nakomis/iphone-remote/hardware/fob/README.md

# Fob board

The trigger fob's PCB, generated by code from the circuit outward. The pipeline is adapted from
tinycrypt's `hardware/key-board` (circuit as Python, EasyEDA footprints via easyeda2kicad,
Freerouting, KiCad DRC, then JLCPCB fab files). The design is in
[`docs/superpowers/specs/2026-11-05-iphone-remote-fob-design.md`](../../docs/superpowers/specs/2026-11-05-iphone-remote-fob-design.md).

**Stage:** laid out and DRC-clean (IREM-4). Next: JLC quote (IREM-5).

## Build

```bash
ASDF_PYTHON_VERSION=3.11.15 python -m venv .venv
.venv/bin/pip install -r requirements.txt
./fetch_parts.sh             # only if footprints/ is missing or a part is added (resumable)
mkdir -p freerouting && cp <somewhere>/freerouting-2.5.0.jar freerouting/   # Java via asdf
.venv/bin/python build.py --route   # full route log: /tmp/irem-fob-route.log
.venv/bin/python -m pytest
```

There's no drawn schematic: `board/fob_board.py` *is* the schematic, and `out/fob/netlist.txt`
lists every net. Comments in it carry Nordic's reference designators (C1 to C10, L1 to L3, X1)
so it can be checked line by line against Nordic's "QCAA QFN32 with DC/DC regulator setup".

## Circuit

| Ref | Part | Notes |
|---|---|---|
| U1 | nRF52810-QCAA-R (C519278) | QFN-32, 0.5 mm pitch |
| BT1 | MY-2032-12 CR2032 holder (C964833) | side clips +, centre pad − |
| C11 | 22 µF 0805 | bulk, at the holder |
| C9, C5, C8 | 4.7 µF, 100 nF, 100 nF | VDD pins 32, 9, 25 |
| C4, C7 | 100 nF, 100 pF | DEC1, DEC3; DEC2 not connected (Nordic C6 N.C.) |
| L2, L3, C10 | 10 µH, 15 nH, 1 µF | DC/DC: DCC → L2 → L3 → DEC4 |
| Y1, C1, C2 | 32 MHz CL 8 pF (C718072), 12 pF ×2 | |
| C3, L1 | 0.8 pF shunt, 3.9 nH series | Nordic's match → 50 Ω `RF` |
| CA1, R3, CA2 | DNP, 0 Ω, DNP | π footprint for retuning the antenna by hand |
| AE1 | Johanson 2450AT18D0100E (C2917718) | pad 1 feed, 2–4 GND (fed from the left) |
| SW1, R2 | TS-1187A (C318884), 1 MΩ pull-up | P0.06, active low |
| D1, R1 | red 0603 LED (C2286), 470 Ω | P0.09, active high |
| JP1–JP3 | solder jumpers to GND | P0.12 / P0.14 / P0.15 = ID bits 0 / 1 / 2 |
| J1 | Tag-Connect TC2030 (legged) | 1 VBAT, 2 SWDIO, 3 nRESET (P0.21), 4 SWDCLK, 5 GND, 6 SWO (P0.18) |
| J2 | 2×6 1.27 mm header, **not fitted** | 1 VBAT, 2 GND, 3 P0.25, 4 P0.00, 5 P0.28, 6 P0.01, 7 P0.30, 8 P0.04, 9 P0.16, 10 P0.05, 11 P0.20, 12 P0.10 (ordered to suit the routing) |

22 parts are assembled, with 7 extended parts. Every LCSC part was checked as in stock and
"Economic and Standard" on its JLC page on 5 Nov 2026.

## Layout (IREM-4)

`build.py --route` writes `out/fob/`: the board (`iphone-remote-fob.kicad_pcb`), `drc.json`,
`bom.csv`, `cpl.csv`, the gerbers zip, top and bottom renders, and
`iphone-remote-fob-outline.dxf` (board edge + courtyards, for the case). Fab files are written
only when KiCad's DRC has no errors and nothing unconnected. Freerouting isn't deterministic;
rerun if a run leaves something open.

- **Board:** 29 × 47 mm, 2 layers, 1.6 mm, every part on top. Antenna on the top edge, the
  nRF52810 just below it with the TC2030 to its right, the unpopulated breakout under the chip,
  the ID jumpers (labelled 1 / 2 / 4) under the TC2030, button and LED below, the CR2032 at the
  far end.
- **Hand-routed** (`board/fob_layout.py`, `rf_hand_route`): the RF chain, crystal, DEC1/3/4, the
  DC/DC, VDD to its three caps, escapes to vias for the pins the router couldn't reach, and the
  TC2030 fan-out (one track per gap between its leg holes, to vias outside them). Freerouting
  does the rest.
- **B.Cu kept solid** under the chip and under the RF line (router keep-outs), with nine vias in
  the chip's exposed pad and GND stitching on a 1.5 mm grid elsewhere.
- **Every GND pad joins the pour solidly** (no thermal spokes).
- **Courtyard overlaps are warnings, not errors** (`kicad_pcb.py` rule severities): the 0402s
  round the QFN sit inside its generous courtyard by design.
- The remaining warnings are silk overlaps and one unused fan-out via.

## Layout rules (from the antenna datasheet)

- **Antenna** (Johanson datasheet, evaluation-board layout): edge-mounted, on the board edge,
  with **no copper on any layer** in a 4.0 × 6.0 mm area around it (pads plus 4.1 mm into the
  board). No battery or metal under it. Grounded-coplanar 50 Ω feed through the R3/CA1/CA2 π.
- Put the antenna at the end away from the button and the CR2032 holder.
- Everything on the top side (JLC Economic). The bottom is ground pour.

## Footprint notes

- `fetch_parts.sh` hit EasyEDA's rate limit for four basic two-pin passives (C1035, C27143,
  C25117, C26083). They use already-fetched footprints of the same package (C0603, L0402,
  R0402), with pin name = pad number, which is all a two-pin part needs.
- The EasyEDA symbols type every pin "unspecified", so `check()` can't catch an unconnected
  power pin; `tests/test_fob_board.py` checks every nRF52810 pad explicitly.
- `footprints/local.pretty` holds KiCad 10 stock footprints: the TC2030 legged footprint, the
  solder jumper and the 2×6 1.27 mm header.
