nakomis/iphone-remote/hardware/fob/art/kappa-photo.jpeg

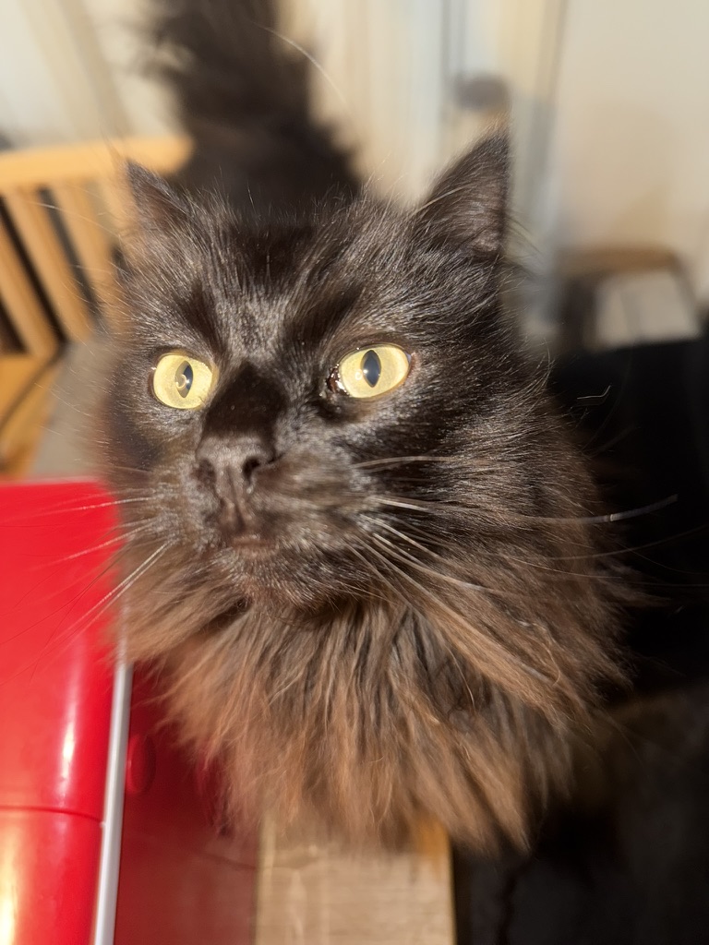
hardware/fob/art/kappa-photo.jpeg
