nakomis/iphone-remote/hardware/fob/art/kappa.png

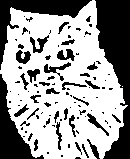
hardware/fob/art/kappa.png
