nakomis/iphone-remote/hardware/fob/out/fob/iphone-remote-fob-bottom.png

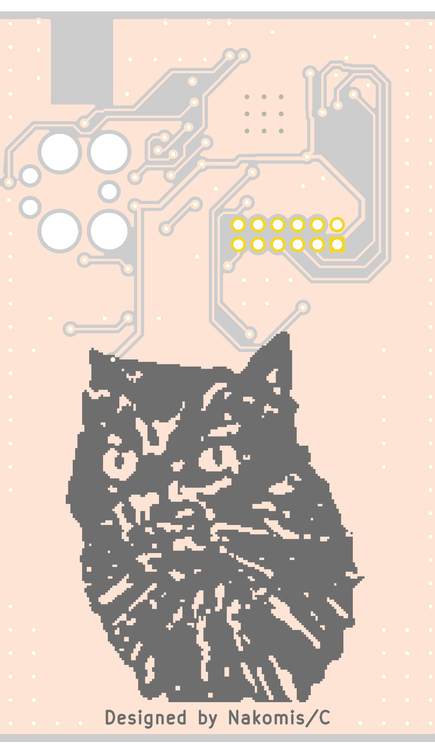
hardware/fob/out/fob/iphone-remote-fob-bottom.png
