nakomis/iphone-remote/hardware/fob/out/fob/iphone-remote-fob-top.png

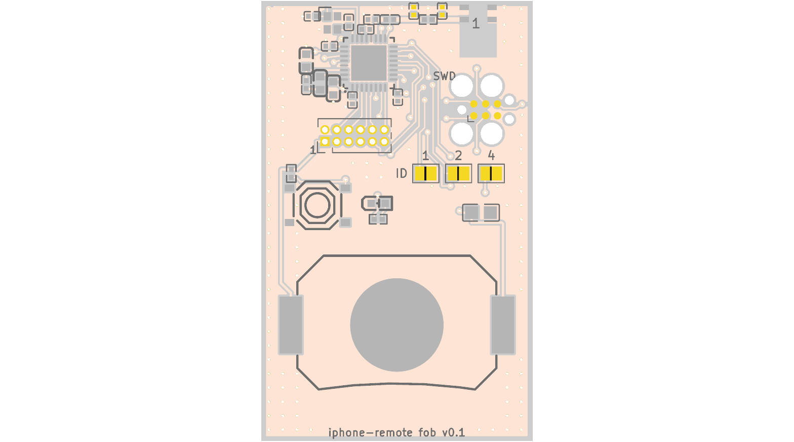
hardware/fob/out/fob/iphone-remote-fob-top.png
