nakomis/iphone-remote/hardware/fob/out/fob/bom.csv

Comment | Designator | Footprint | LCSC Part #
2450AT18D0100E | AE1 | ANT-SMD_4P-L3.2-W1.6 | C2917718
MY-2032-12 | BT1 | BAT-SMD_MY-2032-12 | C964833
12pF | C1,C2 | C0402 | C1547
0.8pF | C3 | C0402 | C327032
100nF | C4,C5,C8 | C0402 | C1525
100pF | C7 | C0402 | C1546
4.7uF | C9 | C0603 | C19666
1uF | C10 | C0603 | C15849
22uF | C11 | C0805 | C45783
KT-0603R red | D1 | LED-SMD_L1.6-W0.8-R-RD | C2286
3.9nH | L1 | L0402 | C14033
10uH | L2 | C0603 | C1035
15nH | L3 | L0402 | C27143
470R | R1 | R0402 | C25117
1M | R2 | R0402 | C26083
0R | R3 | R0402 | C17168
TS-1187A-B-A-B | SW1 | SW-SMD_4P-L5.1-W5.1-P3.70-LS6.5-TL_H1.5 | C318884
nRF52810-QCAA-R | U1 | QFN-32_L5.0-W5.0-P0.50-BL-EP3.8 | C519278
32MHz CL8pF | Y1 | CRYSTAL-SMD_4P-L2.0-W1.6-BL | C718072
