nakomis/iphone-remote/hardware/fob/out/fob/iphone-remote-fob-outline.dxf/iphone-remote-fob-F_Courtyard.dxf

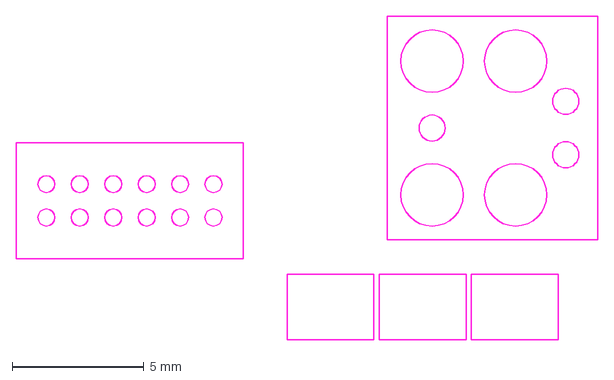
[picture p6: CAD file, 2026-11-05]
hardware/fob/out/fob/iphone-remote-fob-outline.dxf/iphone-remote-fob-F_Courtyard.dxf
22.1 x 12.3 mm
