nakomis/iphone-remote/hardware/fob/out/fob/iphone-remote-fob-outline.dxf/iphone-remote-fob-Edge_Cuts.dxf

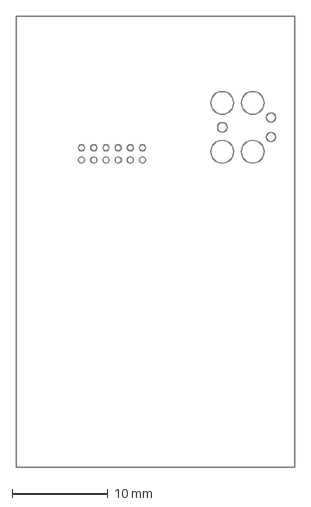
[picture p7: CAD file, 2026-11-05]
hardware/fob/out/fob/iphone-remote-fob-outline.dxf/iphone-remote-fob-Edge_Cuts.dxf
29.0 x 47.0 mm
