nakomis/iphone-remote/hardware/fob/out/fob/iphone-remote-fob.kicad_pcb

## KiCad design hardware/fob/out/fob/iphone-remote-fob.kicad_pcb (2026-11-05)

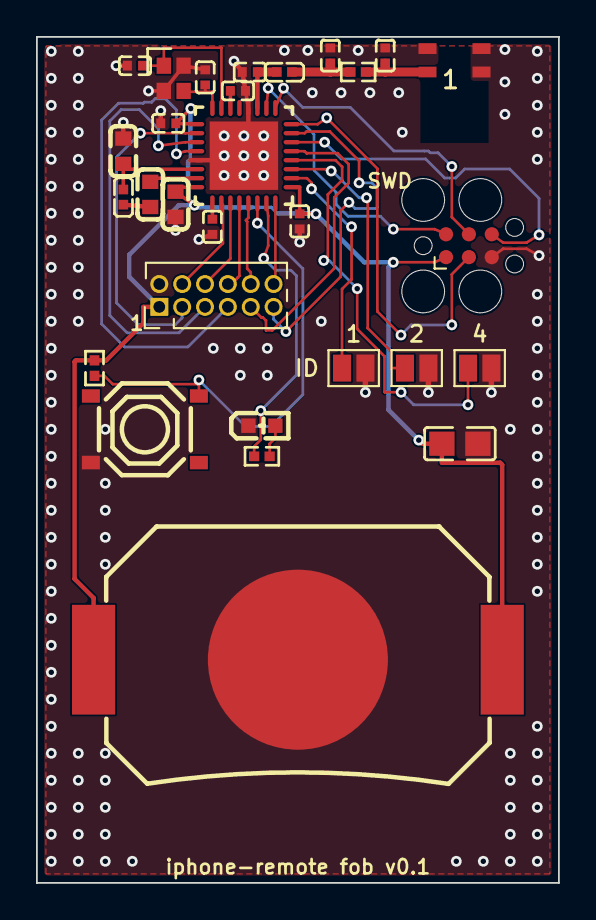
[picture p8: board iphone-remote-fob.kicad_pcb from above]

Board: 2 copper layers, 29.0 x 47.0 mm, 30 parts (1 on the bottom side), 32 nets.

Parts:
AE1: 2450AT18D0100E; ANT-SMD_4P-L3.2-W1.6
ART1: ART1
BT1: MY-2032-12; BAT-SMD_MY-2032-12
C1, C2: 12pF; C0402
C3: 0.8pF; C0402
C4, C5, C8: 100nF; C0402
C7: 100pF; C0402
C9: 4.7uF; C0603
C10: 1uF; C0603
C11: 22uF; C0805
CA1, CA2: DNP; C0402
D1: KT-0603R red; LED-SMD_L1.6-W0.8-R-RD
J1: TC2030-CTX (SWD); Tag-Connect_TC2030-IDC-FP_2x03_P1.27mm_Vertical
J2: 2x6 1.27mm (unpopulated); PinHeader_2x06_P1.27mm_Vertical
JP1, JP2, JP3: Solder jumper; SolderJumper-2_P1.3mm_Open_Pad1.0x1.5mm
L1: 3.9nH; L0402
L2: 10uH; C0603
L3: 15nH; L0402
R1: 470R; R0402
R2: 1M; R0402
R3: 0R; R0402
SW1: TS-1187A-B-A-B; SW-SMD_4P-L5.1-W5.1-P3.70-LS6.5-TL_H1.5
U1: nRF52810-QCAA-R; QFN-32_L5.0-W5.0-P0.50-BL-EP3.8
Y1: 32MHz CL8pF; CRYSTAL-SMD_4P-L2.0-W1.6-BL

Connections:
ANT: C3.1, L1.1, U1.19
ANT_FEED: AE1.1, CA2.1, R3.2
DCC: L2.1, U1.31
DCDC_L: L2.2, L3.1
DEC1: C4.1, U1.1
DEC3: C7.1, U1.22
DEC4: C10.1, L3.2, U1.30
GND: AE1.2, AE1.3, AE1.4, BT1.2, C1.2, C2.2, C3.2, C4.2, C5.2, C7.2, C8.2, C9.2, C10.2, C11.2, CA1.2, CA2.2, D1.2, J1.5, J2.2, JP1.2, JP2.2, JP3.2, SW1.3, U1.20, U1.29, U1.33, Y1.2, Y1.4
LED_A: D1.1, R1.2
NRESET: J1.3, U1.16
P0_00: J2.4, U1.2
P0_01: J2.6, U1.3
P0_04: J2.8, U1.4
P0_05: J2.10, U1.5
P0_06: R2.1, SW1.2, U1.6
P0_09: R1.1, U1.7
P0_10: J2.12, U1.8
P0_12: JP1.1, U1.10
P0_14: JP2.1, U1.11
P0_15: JP3.1, U1.12
P0_16: J2.9, U1.13
P0_20: J2.11, U1.15
P0_25: J2.3, U1.26
P0_28: J2.5, U1.27
P0_30: J2.7, U1.28
RF: CA1.1, L1.2, R3.1
SWDCLK: J1.4, U1.17
SWDIO: J1.2, U1.18
SWO: J1.6, U1.14
VBAT: BT1.1, C5.1, C8.1, C9.1, C11.1, J1.1, J2.1, R2.2, U1.9, U1.25, U1.32
XC1: C1.1, U1.23, Y1.1
XC2: C2.1, U1.24, Y1.3
