nakomis/iphone-remote/(commit log)

2026-11-05 feat(hardware): fob circuit, parts and netlist checks (IREM-3) (#2)
    [bom.csv]
2026-11-05 feat(hardware): fob layout, routed and DRC-clean (IREM-4) (#3)
    [iphone-remote-fob-Edge_Cuts.dxf, iphone-remote-fob-F_Courtyard.dxf, iphone-remote-fob.kicad_pcb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]
2026-11-05 feat(hardware): Kappa on the back silkscreen, black on white (IREM-4) (#4)
    Kappa's portrait (19.5 x 23.85 mm) and 'Designed by Nakomis/C' on B.SilkS under the cell
    holder, from macOS Vision's subject lift plus local-contrast thresholding (art/make_kappa.py,
    inverted from tinycrypt's Mu: the silk is his dark fur, the bare white board his eyes and
    highlights). Stitching keeps out of the portrait and credit; renders use white mask, black silk.
    DRC: 0 errors.
    [iphone-remote-fob.kicad_pcb]
2026-11-05 feat(firmware): fob firmware (IREM-6) (#6)
    * feat(firmware): fob firmware, board definition and protocol tests (IREM-6)
    * feat(firmware): builds for the fob and the Pro Micro; size check, CI for the host tests (IREM-6)
    * fix(firmware): late acks can't end a newer press, non-blocking LED, VDD read off-load, static address (IREM-6)
    [main.c, protocol.c, protocol.h]
2026-11-06 feat(firmware): ESP32-S3 fob emulator and Mac phone stand-in (IREM-8) (#8)
    Sends the fob's exact v1 press advert (built by fob/src/protocol.c), listens
    for the ack at the fob's 50% duty, then surveys the ack at 100% duty. Reports
    latency, whether the ack is in the primary advert, and ack packets per press.
    A monitor mode measures a phone's advertising interval.
    tools/phone.swift acks presses on a Mac per protocol.md section 3-4. Against
    it: round trip works, ack in the primary advert, but macOS advertises every
    ~182 ms, so a 150 ms ack is caught only ~40% of the time.
2026-11-09 fix(hardware): swap the sold-out antenna for the same part on another reel (IREM-4) (#9)
    C2917718 (2450AT18D0100E) is out of stock at JLC. C17410360
    (2450AT18D0100002E) is the same Johanson antenna: identical EasyEDA
    footprint, Economic and Standard, MSL 1, 895 in stock. BOM only; the
    layout, Gerbers and CPL are unchanged.
    [bom.csv, iphone-remote-fob.kicad_pcb]
2026-11-09 revert: keep C2917718 antenna, which the ordered boards carry (IREM-4) (#10)
    This reverts #9. The order went through with C2917718 before it sold out;
    the swap was for a stale cart. C17410360 (2450AT18D0100002E, identical
    footprint) is the drop-in for any reorder.
2026-11-09 revert: keep C2917718 antenna, which the ordered boards carry (IREM-4) (#11)
    Reverts #9 (#10 merged without the file changes). C17410360
    (2450AT18D0100002E, identical footprint) is the drop-in for any reorder.
    [bom.csv, iphone-remote-fob.kicad_pcb]
